andyjpb/sunflower/tools/output.pdf

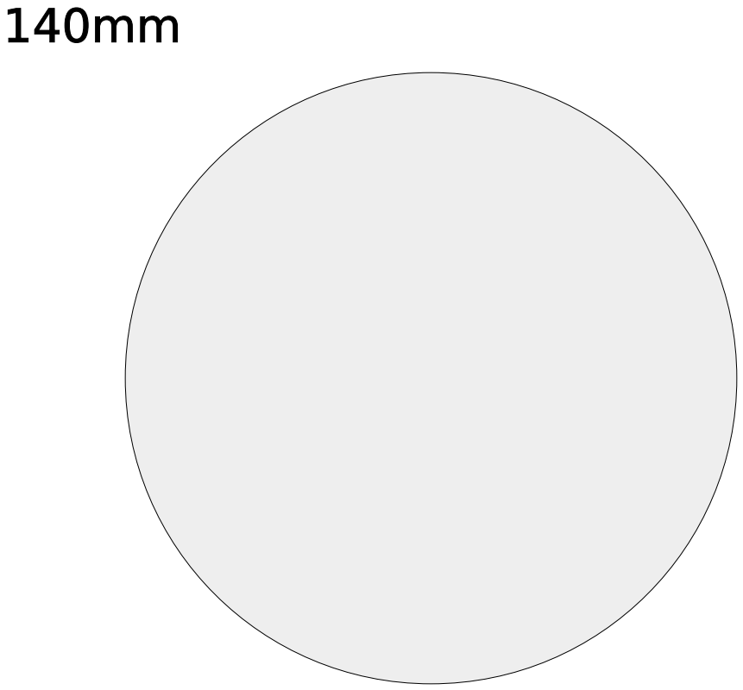
[picture p29: figure]
