andyjpb/sunflower/cad/sunflower/drivers.kicad_pcb

## KiCad design cad/sunflower/drivers.kicad_pcb (2024-07-30)

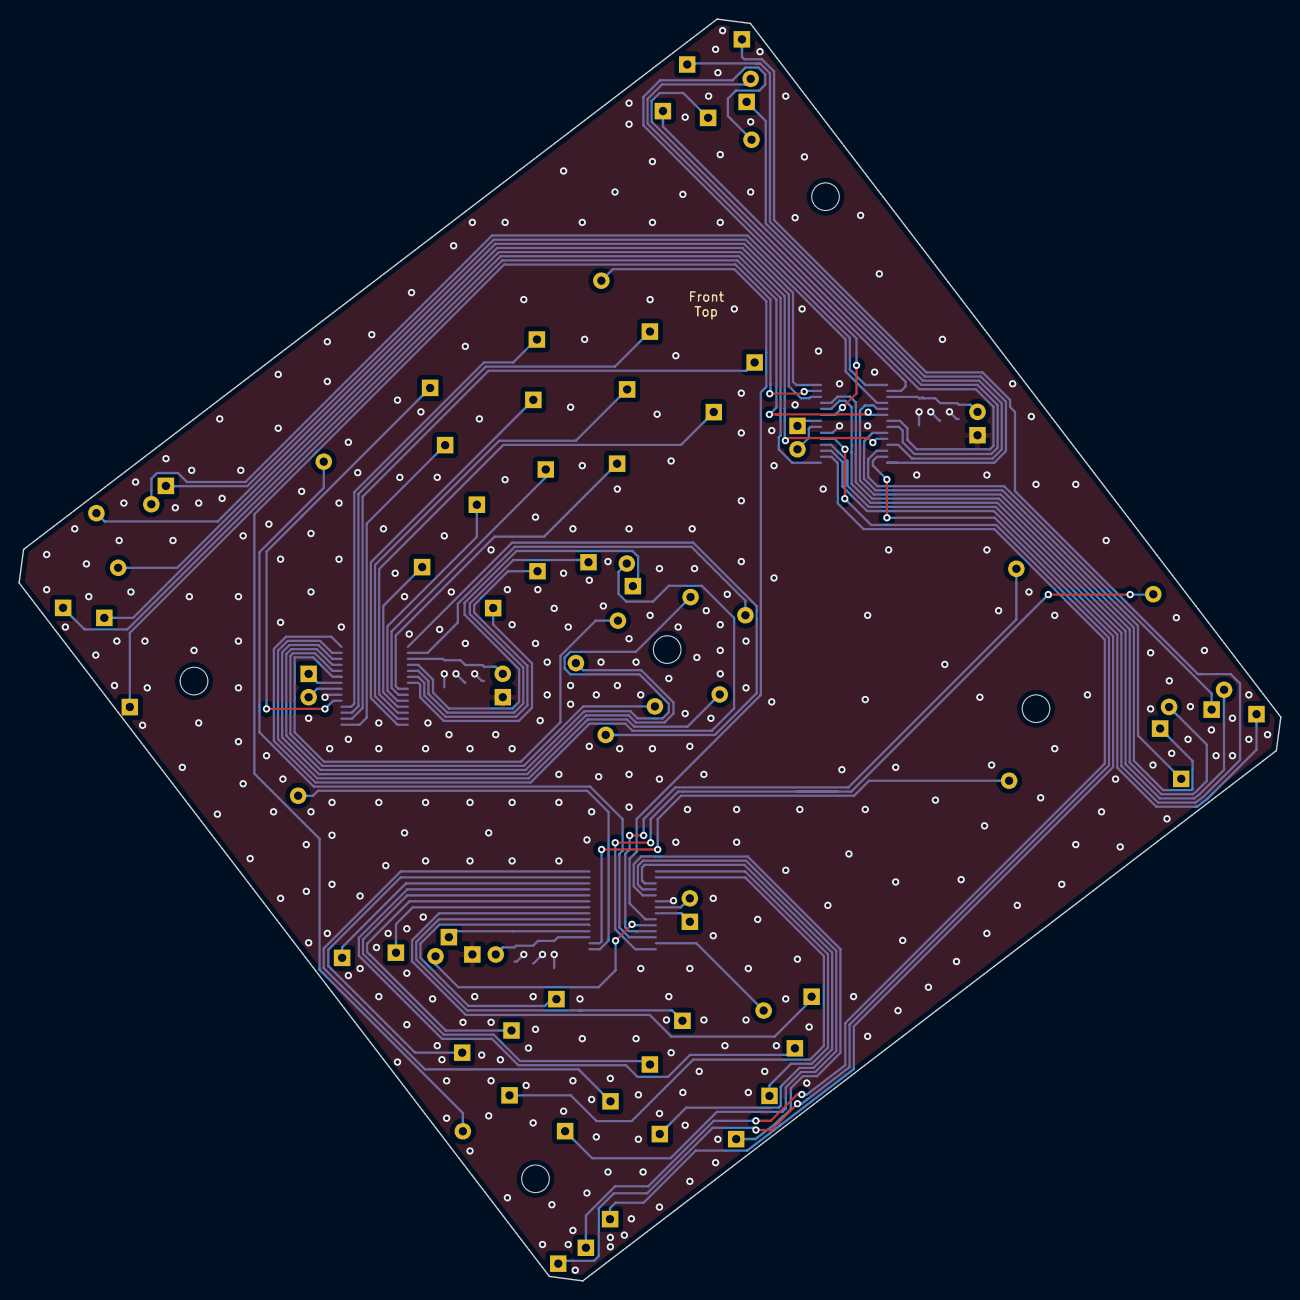
[picture p32: board drivers.kicad_pcb from above]

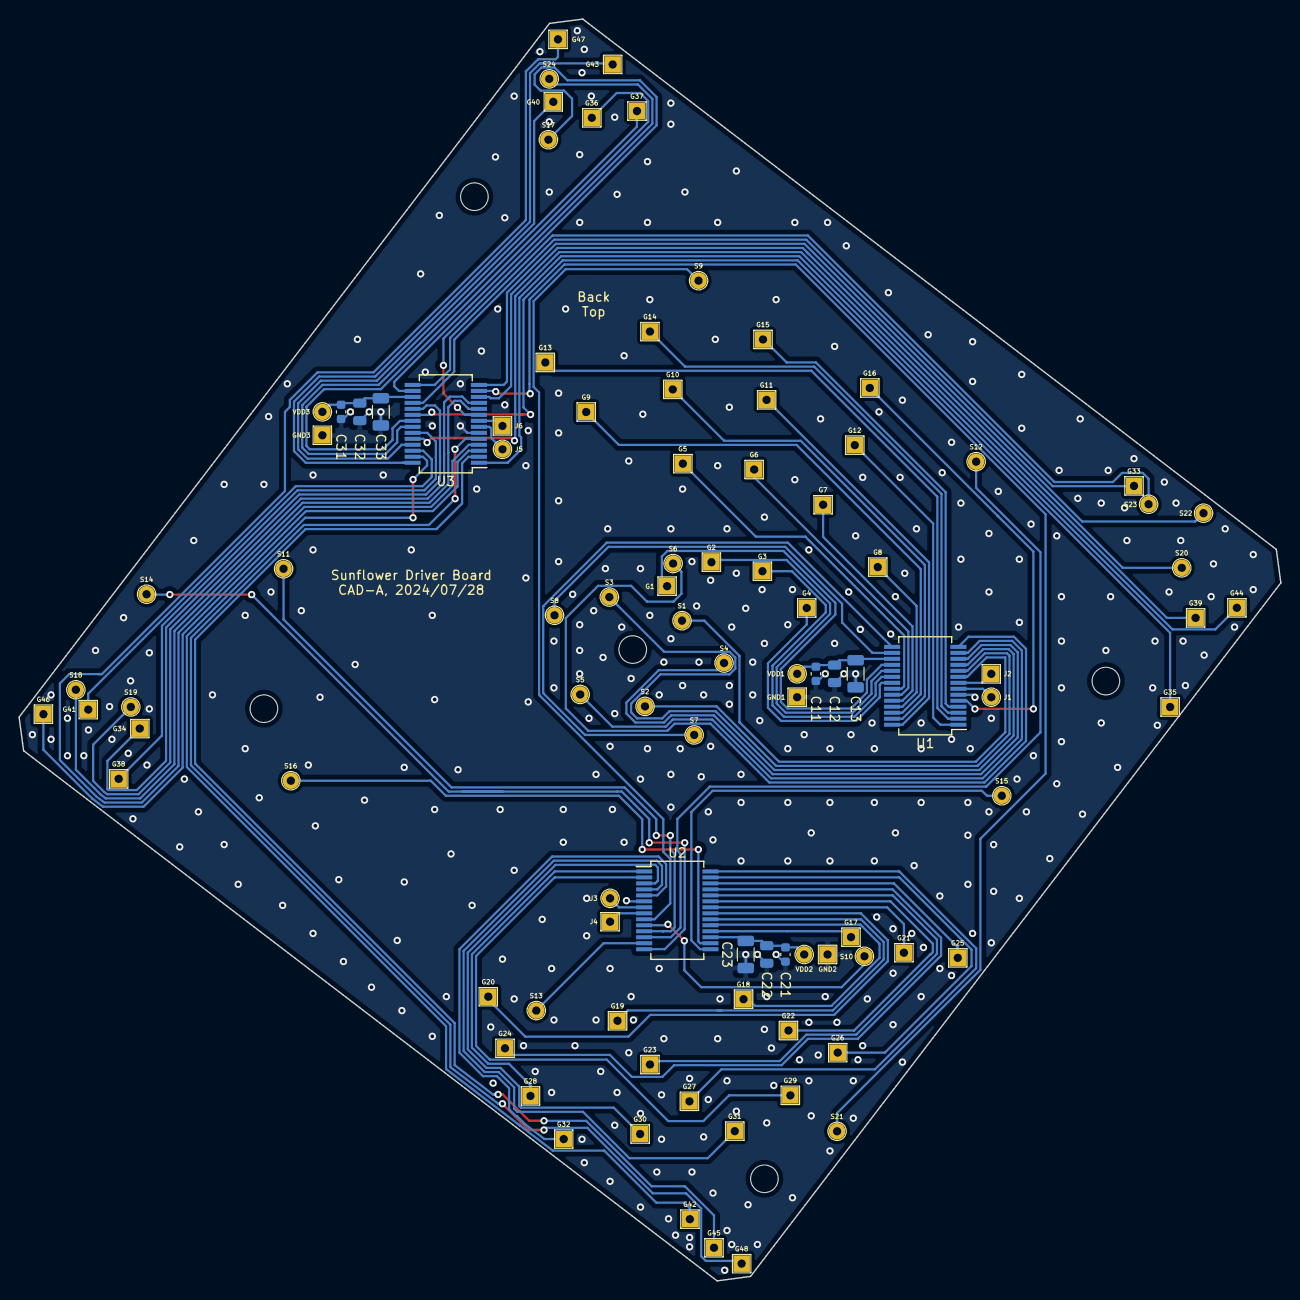
[picture p33: board drivers.kicad_pcb from below]

Board: 2 copper layers, 137.0 x 137.0 mm, 96 parts (96 on the bottom side), 80 nets.

Parts:
C11, C21, C31: 100n; C_0603_1608Metric
C12, C22, C32: 10u; C_0805_2012Metric
C13, C23, C33: 47u; C_1206_3216Metric
G1, G2, G3, G4, G5, G6, G7, G8, G9, G10, G11, G12, G13, G14, G15, G16, G17, G18, G19, G20, G21, G22, G23, G24, G25, G26, G27, G28, G29, G30, G31, G32, G33, G34, G35, G36, G37, G38, G39, G40, G41, G42, G43, G44, G45, G46, G47, G48: Conn_01x01; Link_Square
GND1, GND2, GND3: Conn_01x01; Link_Square
J1, J3, J5: Conn_01x01; Link_Round
J2, J4, J6: Conn_01x01; Link_Square
S1, S2, S3, S4, S5, S6, S7, S8, S9, S10, S11, S12, S13, S14, S15, S16, S17, S18, S19, S20, S21, S22, S23, S24: Conn_01x01; Link_Round
U1, U2, U3: TM1640; SSOP-28_5.3x10.2mm_P0.65mm
VDD1, VDD2, VDD3: Conn_01x01; Link_Round

Connections:
5V: C11.1, C12.1, C13.1, C21.1, C22.1, C23.1, C31.1, C32.1, C33.1, U1.17, U2.17, U3.17, VDD1.1, VDD2.1, VDD3.1
/matrix-1/DIN: J1.1, U1.7
/matrix-1/GRID1: G1.1, U1.18
/matrix-1/GRID2: G2.1, U1.19
/matrix-1/GRID3: G3.1, U1.20
/matrix-1/GRID4: G4.1, U1.21
/matrix-1/GRID5: G5.1, U1.22
/matrix-1/GRID6: G6.1, U1.23
/matrix-1/GRID7: G7.1, U1.24
/matrix-1/GRID8: G8.1, U1.25
/matrix-1/GRID9: G9.1, U1.26
/matrix-1/GRID10: G10.1, U1.27
/matrix-1/GRID11: G11.1, U1.28
/matrix-1/GRID12: G12.1, U1.1
/matrix-1/GRID13: G13.1, U1.2
/matrix-1/GRID14: G14.1, U1.3
/matrix-1/GRID15: G15.1, U1.4
/matrix-1/GRID16: G16.1, U1.5
/matrix-1/SCLK: J2.1, U1.8
/matrix-1/SEG1: S1.1, U1.9
/matrix-1/SEG2: S2.1, U1.10
/matrix-1/SEG3: S3.1, U1.11
/matrix-1/SEG4: S4.1, U1.12
/matrix-1/SEG5: S5.1, U1.13
/matrix-1/SEG6: S6.1, U1.14
/matrix-1/SEG7: S7.1, U1.15
/matrix-1/SEG8: S8.1, U1.16
/matrix-2/DIN: J3.1, U2.7
/matrix-2/GRID1: G17.1, U2.18
/matrix-2/GRID2: G18.1, U2.19
/matrix-2/GRID3: G19.1, U2.20
/matrix-2/GRID4: G20.1, U2.21
/matrix-2/GRID5: G21.1, U2.22
/matrix-2/GRID6: G22.1, U2.23
/matrix-2/GRID7: G23.1, U2.24
/matrix-2/GRID8: G24.1, U2.25
/matrix-2/GRID9: G25.1, U2.26
/matrix-2/GRID10: G26.1, U2.27
/matrix-2/GRID11: G27.1, U2.28
/matrix-2/GRID12: G28.1, U2.1
/matrix-2/GRID13: G29.1, U2.2
/matrix-2/GRID14: G30.1, U2.3
/matrix-2/GRID15: G31.1, U2.4
/matrix-2/GRID16: G32.1, U2.5
/matrix-2/SCLK: J4.1, U2.8
/matrix-2/SEG1: S9.1, U2.9
/matrix-2/SEG2: S10.1, U2.10
/matrix-2/SEG3: S11.1, U2.11
/matrix-2/SEG4: S12.1, U2.12
/matrix-2/SEG5: S13.1, U2.13
/matrix-2/SEG6: S14.1, U2.14
/matrix-2/SEG7: S15.1, U2.15
/matrix-2/SEG8: S16.1, U2.16
/matrix-3/DIN: J5.1, U3.7
/matrix-3/GRID1: G33.1, U3.18
/matrix-3/GRID2: G34.1, U3.19
/matrix-3/GRID3: G35.1, U3.20
/matrix-3/GRID4: G36.1, U3.21
/matrix-3/GRID5: G37.1, U3.22
/matrix-3/GRID6: G38.1, U3.23
/matrix-3/GRID7: G39.1, U3.24
/matrix-3/GRID8: G40.1, U3.25
/matrix-3/GRID9: G41.1, U3.26
/matrix-3/GRID10: G42.1, U3.27
/matrix-3/GRID11: G43.1, U3.28
/matrix-3/GRID12: G44.1, U3.1
/matrix-3/GRID13: G45.1, U3.2
/matrix-3/GRID14: G46.1, U3.3
/matrix-3/GRID15: G47.1, U3.4
/matrix-3/GRID16: G48.1, U3.5
/matrix-3/SCLK: J6.1, U3.8
/matrix-3/SEG1: S17.1, U3.9
/matrix-3/SEG2: S18.1, U3.10
/matrix-3/SEG3: S19.1, U3.11
/matrix-3/SEG4: S20.1, U3.12
/matrix-3/SEG5: S21.1, U3.13
/matrix-3/SEG6: S22.1, U3.14
/matrix-3/SEG7: S23.1, U3.15
/matrix-3/SEG8: S24.1, U3.16
GND: C11.2, C12.2, C13.2, C21.2, C22.2, C23.2, C31.2, C32.2, C33.2, GND1.1, GND2.1, GND3.1, U1.6, U2.6, U3.6
