andyjpb/sunflower/(commit log)

2024-07-30 Initial notes and resources.
    + Datasheet for TM1640 LED Driver
    + seedsDYNAMIC.xls from https://web.archive.org/web/20090530011347/http://www.mcs.surrey.ac.uk/Personal/R.Knott/Fibonacci/seedsDYNAMIC.xls
    + Project notes
    [seedsDYNAMIC.xls]
2024-07-30 Tool to position sunflower seeds in SVG and on a Kicad PCB.
2024-07-30 Spreadsheet for deciding interboard connections
    Where should the square(-ish) driver board connect to the
    round sunflower board?
    We need a connection for each GRID and SEG line for each
    LED driver.
    [interboard.ods]
2024-07-30 Script to annotate sunflower PCB with GRID and SEG silkscreens
    A script to mark the back of the sunflower PCB with the
    LED legs that need to be left uncut because they connect
    GRID and SEG lines to the driver board.
    This also marks the extra pads that have been added to
    the sunflower board where there is no existing LED leg
    that will work. In these cases, the pads can end up being
    marked with both a circle and a square silkscreen.
2024-07-30 Kicad project files
    + Schematic
    + Sunflower PCB
    + Driver PCB
    + Custom LED and Link footprints
    [drivers.kicad_pcb, matrix.sch, sunflower.kicad_pcb, sunflower.sch]
2024-07-30 Backup PCB files
2024-07-30 CAD-A Gerbers to JLCPCB specs
    As per
    https://jlcpcb.com/help/article/42-How-to-generate-Gerber-and-Drill-files-in-KiCad-4
    and
    https://jlcpcb.com/help/article/2201-how-to-generate-gerber-and-drill-files-in-kicad-8
    I tried to use the KiCad 8 settings but needed the KiCad 4 guide to find
    the right menu options (File -> Plot) and to compare UI differences with
    the KiCad 5.1.9 I was using.
    [drivers-B_Cu.gbl, drivers-B_Mask.gbs, drivers-B_Paste.gbp, drivers-B_SilkS.gbo, drivers-Edge_Cuts.gm1, drivers-F_Cu.gtl, drivers-F_Mask.gts, drivers-F_Paste.gtp]
2024-07-30 Gerber zip files as provided to JLCPCB for manufacturing.
2024-08-27 PCB Soldering & Assembly Instructions
    Typed up from the notes I made as I did it.
